w-ockham/WiFiKey/(commit log)

2021-08-11 Add variable timing control and web server funtion for parameter setting.
2021-08-11 Fix global variable initializer.
    [WiFiKey.ino]
2021-08-18 Reset sever state when WiFi connection losts.
    [WiFiKey.ino]
2021-08-24 Reset packet error counter in each session.
    [WiFiKey.ino]
2021-08-26 Add remote config, error messsages, reboot/restore buttion.
    [WiFiKey.ino]
2021-08-31 Fix configration update timing.
    [WiFiKey.cpp]
2021-09-02 Fix key input deboune.
    [WiFiKey.cpp]
2021-09-02 Add status LED for ATOMLite.
